vassar-cogscilab/arduino-framerate-debugger/InterruptPulseTimerLCD/Pictures/20190521_164954.jpg

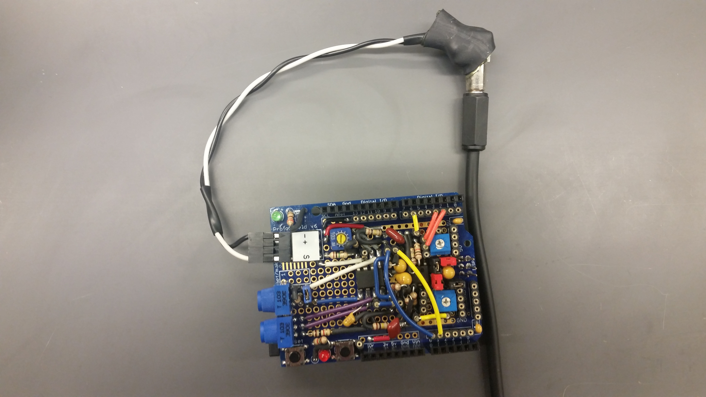
InterruptPulseTimerLCD/Pictures/20190521_164954.jpg
