vassar-cogscilab/arduino-framerate-debugger/InterruptPulseTimerLCD/Pictures/Wave Peak Labeled.jpg

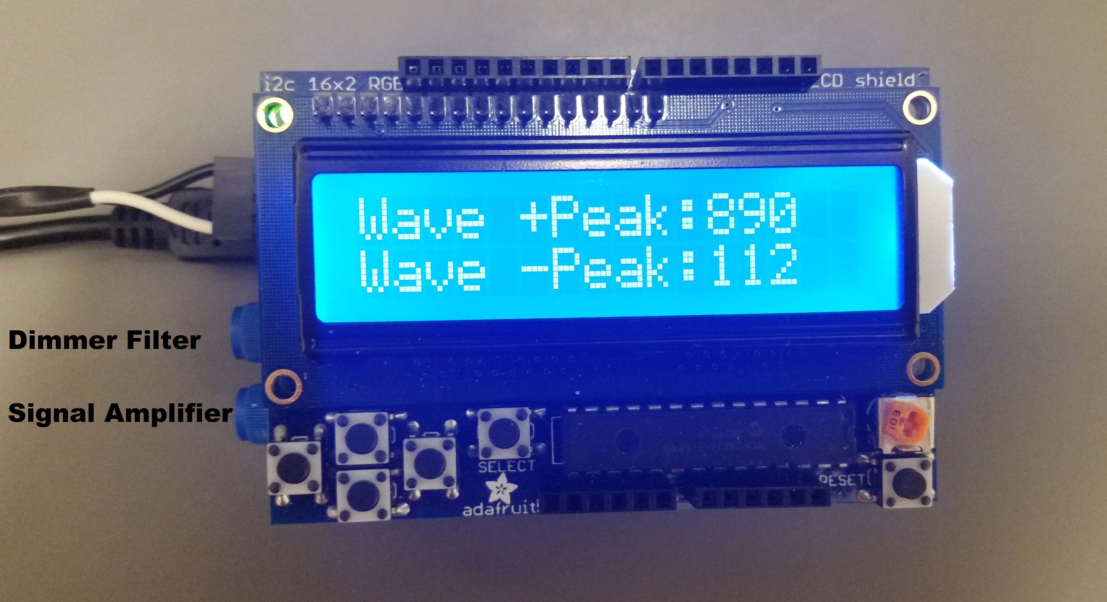
InterruptPulseTimerLCD/Pictures/Wave Peak Labeled.jpg
