vassar-cogscilab/arduino-framerate-debugger/README.md

# arduino-framerate-debugger
Code to control an Arduino-based device that measures true frame rate.
