vassar-cogscilab/arduino-framerate-debugger/InterruptPulseTimerLCD/Pictures/20190129_133350.jpg

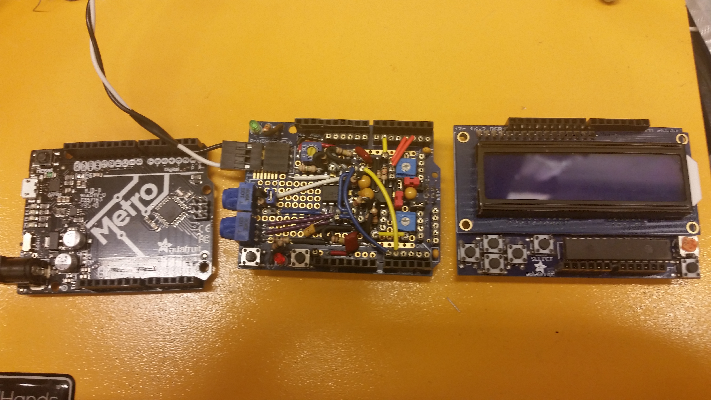
InterruptPulseTimerLCD/Pictures/20190129_133350.jpg
