vassar-cogscilab/arduino-framerate-debugger/InterruptPulseTimerLCD/Pictures/20190221_151906 - Copy.jpg

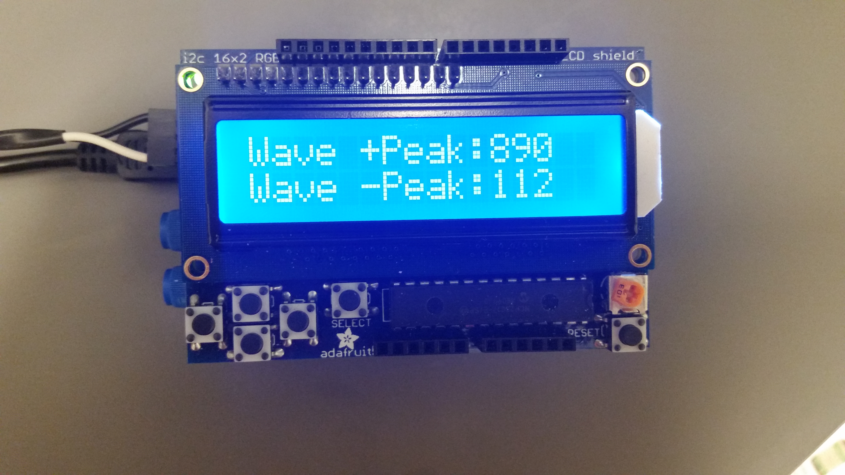
InterruptPulseTimerLCD/Pictures/20190221_151906 - Copy.jpg
