vassar-cogscilab/arduino-framerate-debugger/InterruptPulseTimerLCD/Pictures/20190221_152434.jpg

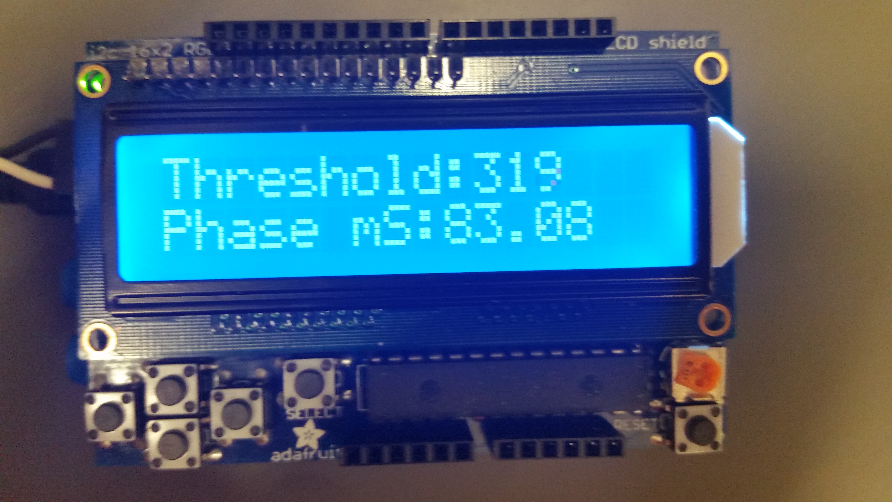
InterruptPulseTimerLCD/Pictures/20190221_152434.jpg
