vassar-cogscilab/arduino-framerate-debugger/InterruptPulseTimerLCD/Pictures/20190221_152759.jpg

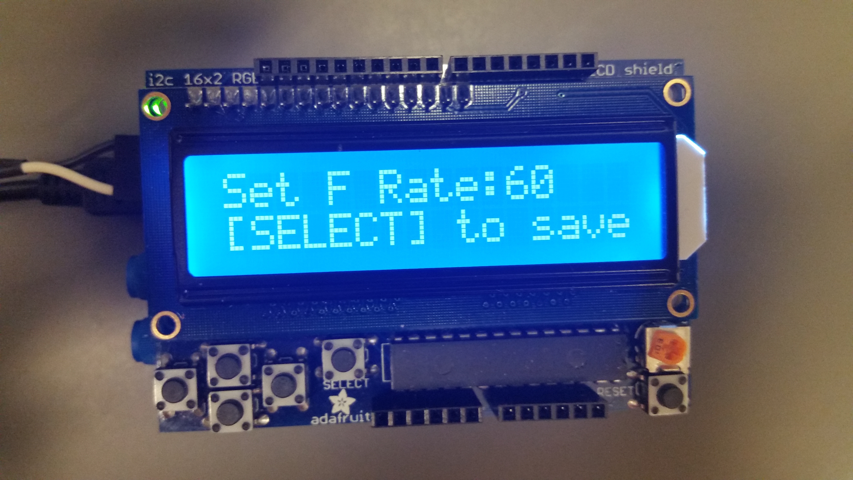
InterruptPulseTimerLCD/Pictures/20190221_152759.jpg
