vassar-cogscilab/arduino-framerate-debugger/InterruptPulseTimerLCD/Pictures/20190221_152906.jpg

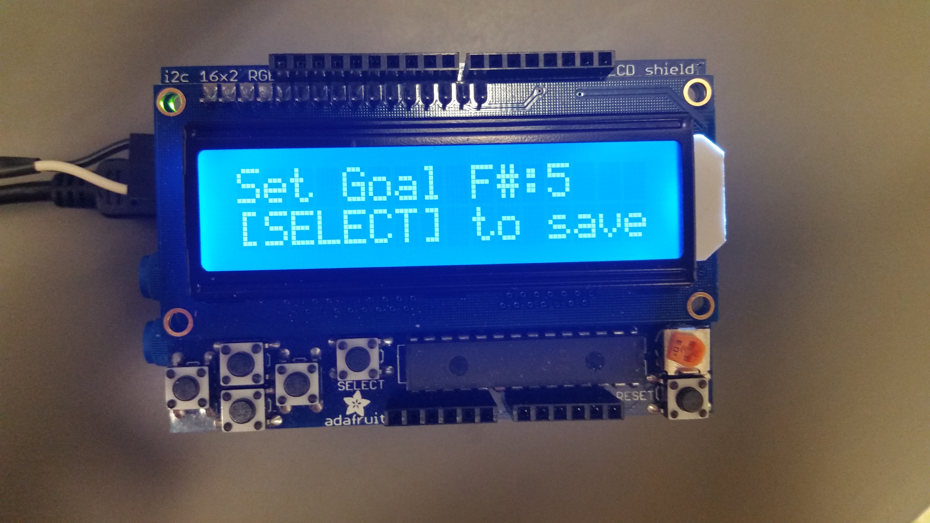
InterruptPulseTimerLCD/Pictures/20190221_152906.jpg
