vassar-cogscilab/arduino-framerate-debugger/InterruptPulseTimerLCD/Pictures/20190221_153031.jpg

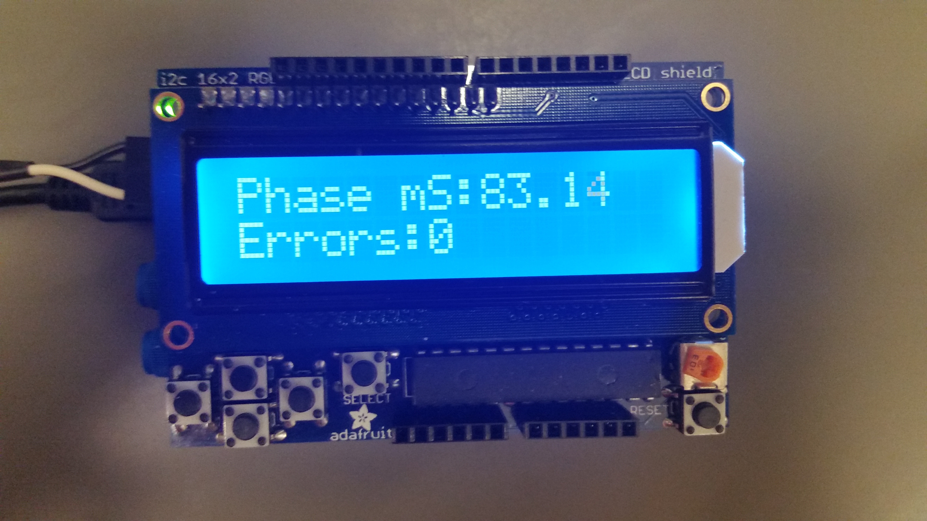
InterruptPulseTimerLCD/Pictures/20190221_153031.jpg
