vassar-cogscilab/arduino-framerate-debugger/InterruptPulseTimerLCD/Pictures/20190221_153229.jpg

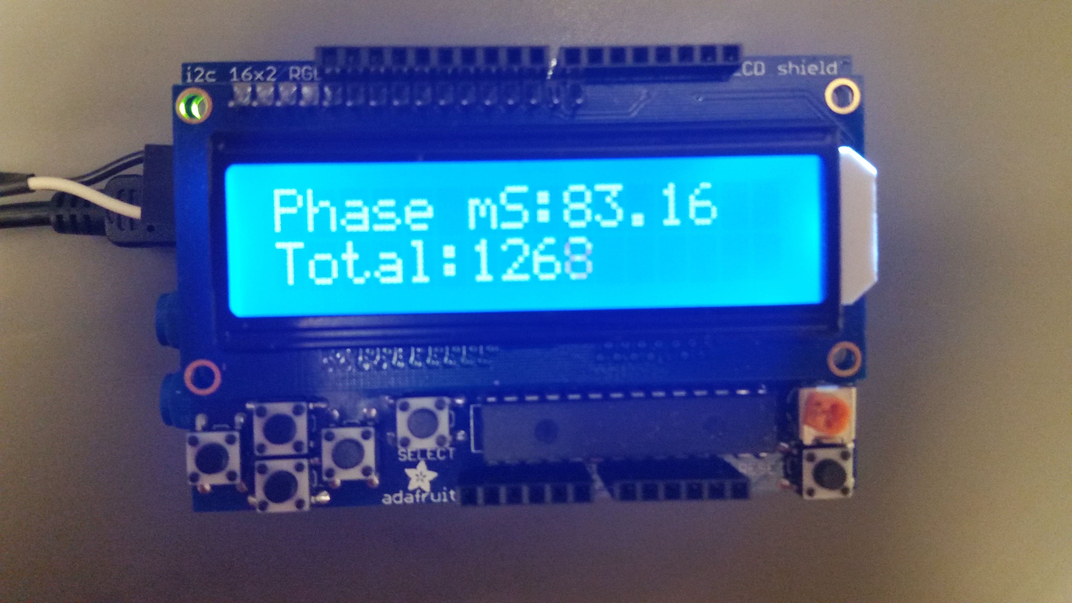
InterruptPulseTimerLCD/Pictures/20190221_153229.jpg
