vassar-cogscilab/arduino-framerate-debugger/InterruptPulseTimerLCD/Pictures/20190522_111648.jpg

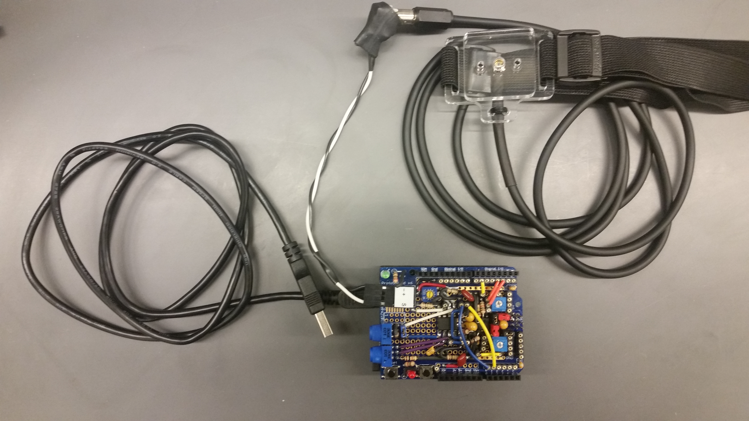
InterruptPulseTimerLCD/Pictures/20190522_111648.jpg
