vassar-cogscilab/arduino-framerate-debugger/InterruptPulseTimerLCD/Pictures/20190522_111733.jpg

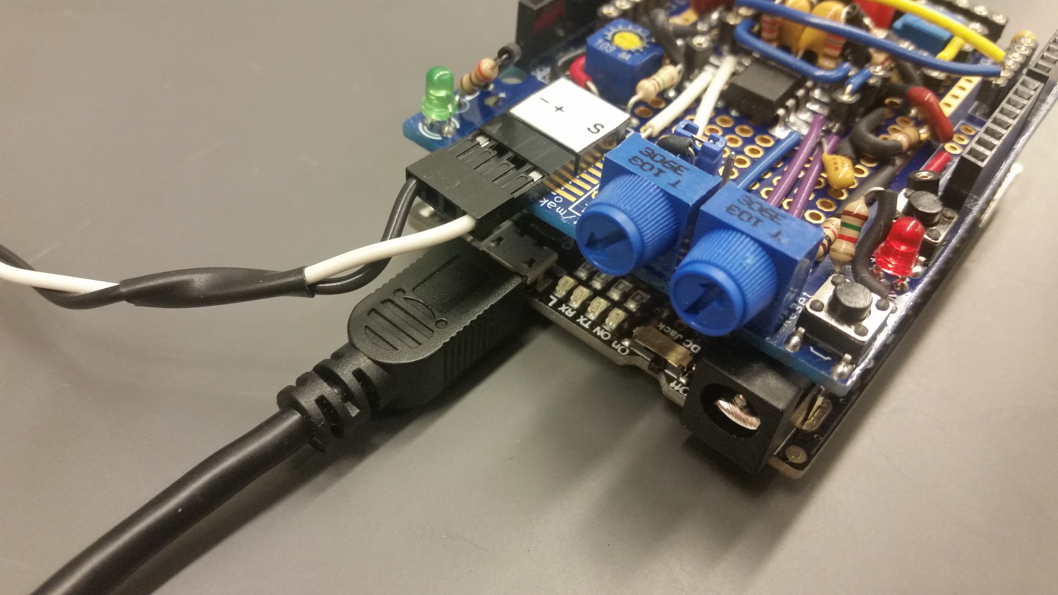
InterruptPulseTimerLCD/Pictures/20190522_111733.jpg
