vassar-cogscilab/arduino-framerate-debugger/InterruptPulseTimerLCD/Pictures/20190522_112225.jpg

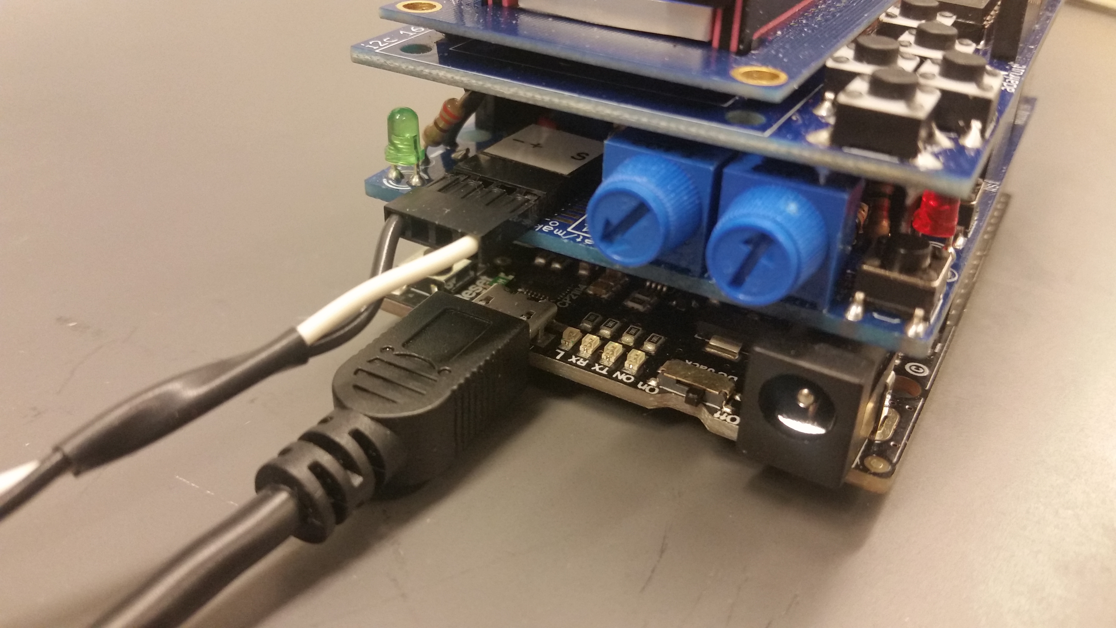
InterruptPulseTimerLCD/Pictures/20190522_112225.jpg
