vassar-cogscilab/arduino-framerate-debugger/InterruptPulseTimerLCD/Pictures/20190522_143142.jpg

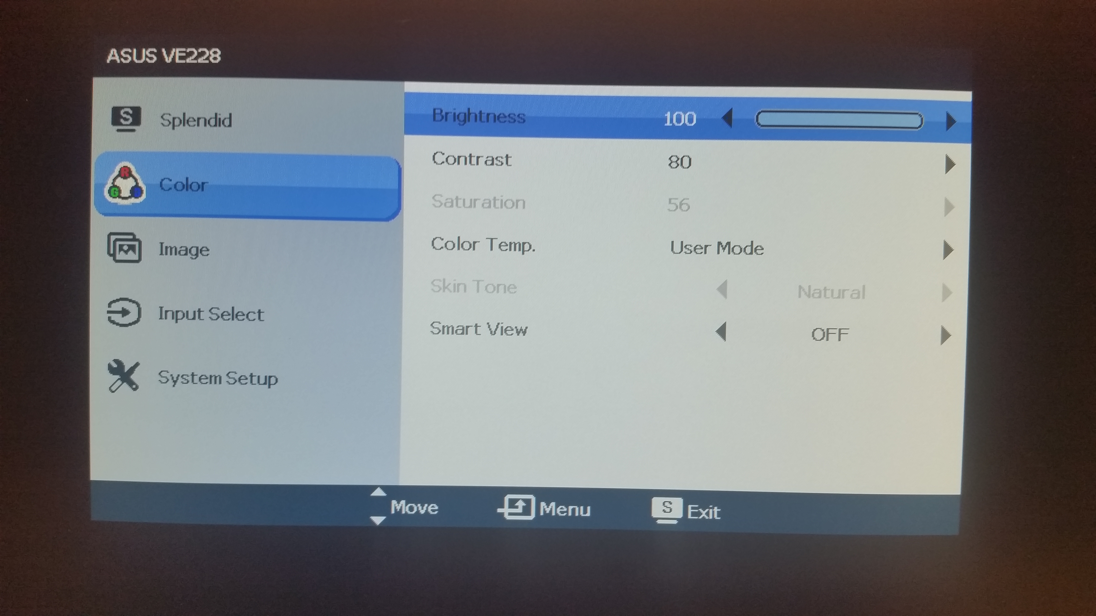
InterruptPulseTimerLCD/Pictures/20190522_143142.jpg
