vassar-cogscilab/arduino-framerate-debugger/InterruptPulseTimerLCD/Pictures/20190522_155322.jpg

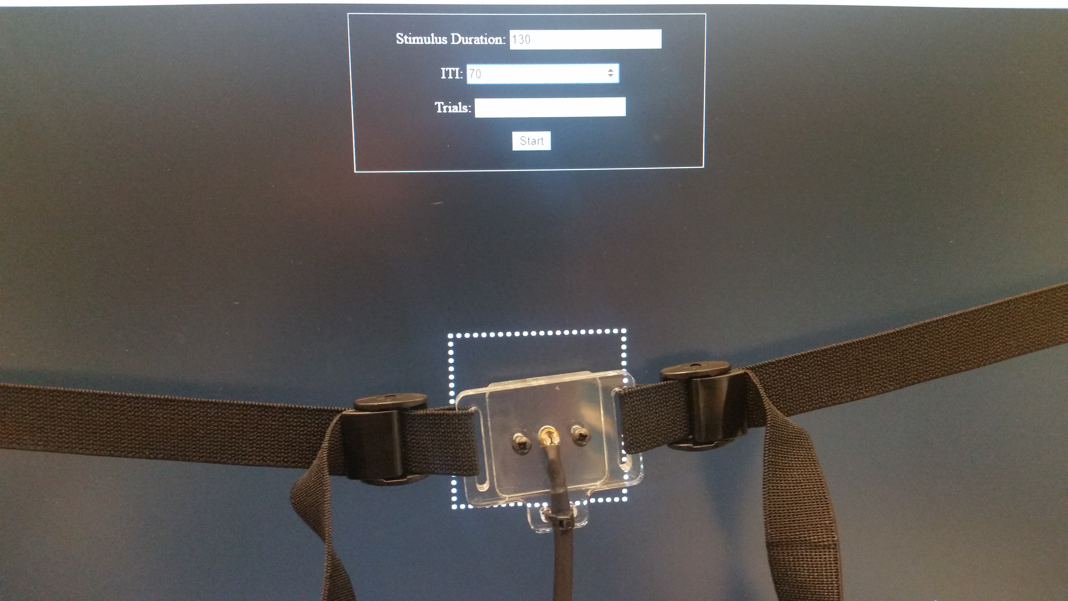
InterruptPulseTimerLCD/Pictures/20190522_155322.jpg
