vassar-cogscilab/arduino-framerate-debugger/InterruptPulseTimerLCD/Pictures/Advanced Display Settigns highlighted.png

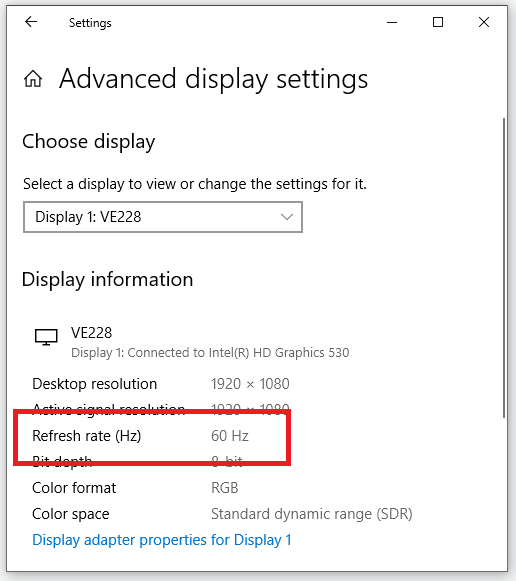
InterruptPulseTimerLCD/Pictures/Advanced Display Settigns highlighted.png
