vassar-cogscilab/arduino-framerate-debugger/(commit log)

2019-01-07 Revert "Delete frame_rate_debugger.ino"
    This reverts commit a775a067b5f1995361faaf2a3890cb9dffbbb264.
    [frame_rate_debugger.ino]
2019-01-07 Add current rev
2019-01-07 Compress reset and freq/duty behavior into FOR loops
    [InterruptPulseTimerLCD.ino]
2019-01-09 2kHz. 100% sample. Calc in ISR. removed averaging
2019-01-15 add prototype notes for frame count
2019-01-16 Add error count. Improve ISR comments and structure.
    [InterruptPulseTimerLCD.ino]
2019-01-21 Made buttonCheck void
2019-01-22 Change mode switch behavior. Correct error in first period calculation.
    [InterruptPulseTimerLCD.ino]
2019-01-25 Add threshold PWM setup mode
2019-01-29 Added schematic and simulation documentation
2019-01-29 Change default thresh PWM to 75
2019-01-30 Fix freq and duty cycle min/max values
    [InterruptPulseTimerLCD.ino]
2019-01-30 Add interrupt flag clearing after data reset.
    [InterruptPulseTimerLCD.ino]
2019-02-01 Replace sample counts with error counts in ppfdSub displays
    [InterruptPulseTimerLCD.ino]
2019-02-01 Removed unused sample update count variables.
2019-02-01 Revert "Removed unused sample update count variables."
    This reverts commit 1de57da5955d7849b27d652aed6889888b4617c4.
    [InterruptPulseTimerLCD.ino]
2019-02-01 Add calcUpdateFlag to fix min/max string values causing overflow after reset
    [InterruptPulseTimerLCD.ino]
2019-02-01 Unrolled FOR loop in waveReset for minimized interrupt down time
2019-02-01 Rebuild frame count logic prototype
2019-02-02 Update frame count prototype
2019-02-02 build analog wave display prototype
2019-02-04 Update and document error detection logic.
    [InterruptPulseTimerLCD.ino]
2019-02-04 Unrolled loops in ISRwaveCalc. Move totalCount to only update if in total print mode
2019-02-04 Revise frame count prototype
2019-02-04 Add frame count display mode
2019-02-04 added frame counter Rev1
2019-02-04 Update frame count logic and move waveEndTime to local variable
2019-02-05 Add frame rate setting mode
2019-02-05 Add frame count goal setting mode
2019-02-05 Change default frame count goal to 1
2019-02-05 Change frame count print labels
2019-02-05 Increase analog wave sample loop count to 4
2019-02-06 Update and expand interrupt tutorial comments
2019-02-13 Create Features.md
    Outline of features and setting of available in the device.
2019-02-13 Fixed low pass filter overview formatting.
2019-02-27 Set analog wave level as starting mode. Removed unused sampleCounts variable.
2019-02-27 Fix value update bug in analog wave mode. Change autoThresh delay.
    [InterruptPulseTimerLCD.ino]
2019-02-27 Update analog wave comments. Remove debug serial printing from autoThresh.
2019-05-23 Increased wave peak sample loops for improved threshold calibration at low frame rates.
